julianjc84/VORON_2.4_TOP_MOUNT_XRAIL/images/current/bottom.jpg

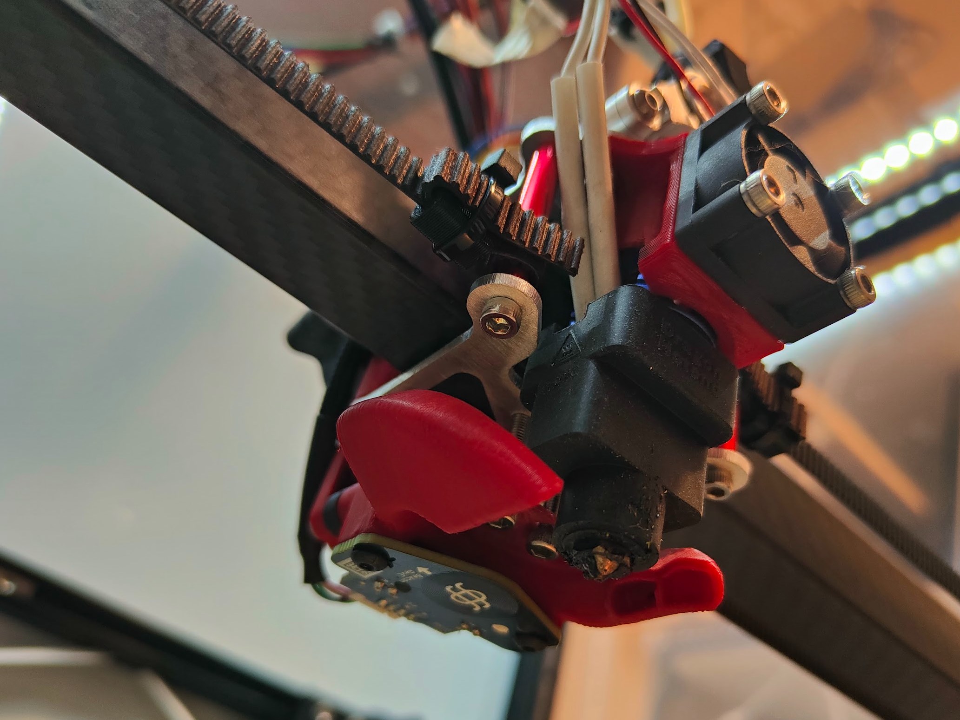
images/current/bottom.jpg
