julianjc84/VORON_2.4_TOP_MOUNT_XRAIL/images/v4/top_belt.png

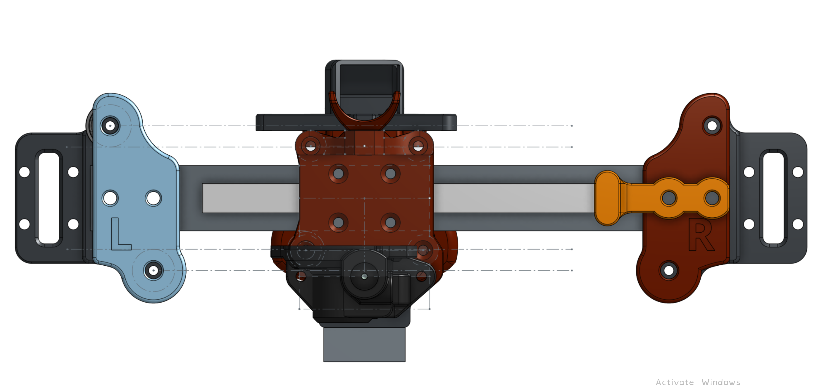
images/v4/top_belt.png
