julianjc84/VORON_2.4_TOP_MOUNT_XRAIL/images/vz/vzangled_belts.jpg

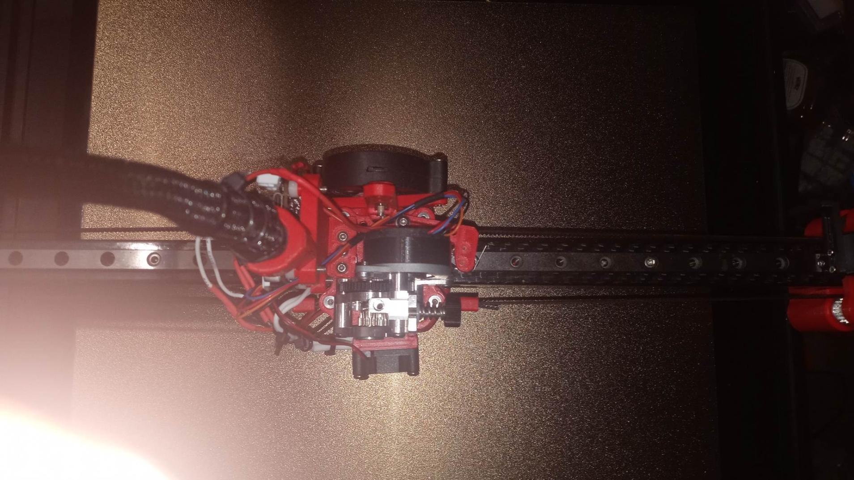
images/vz/vzangled_belts.jpg
