julianjc84/VORON_2.4_TOP_MOUNT_XRAIL/images/vz/vzstandard-vs-rr.png

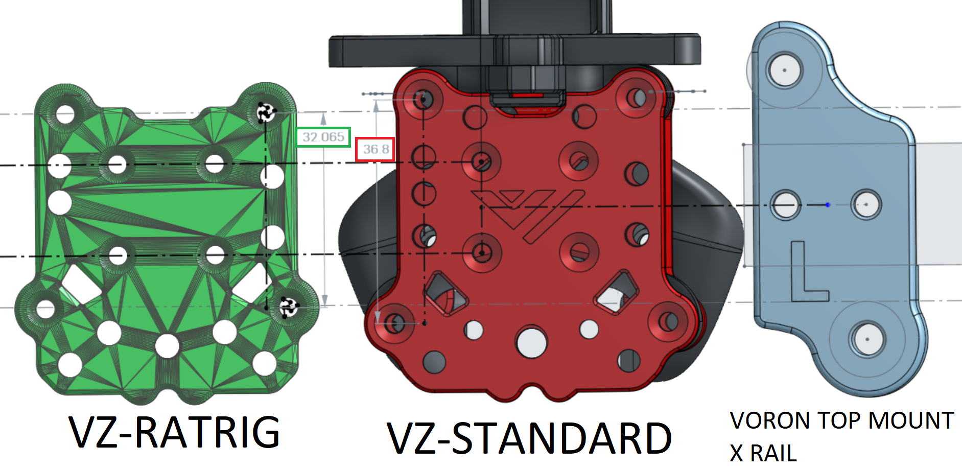
images/vz/vzstandard-vs-rr.png
