julianjc84/VORON_2.4_TOP_MOUNT_XRAIL/STL/LASERCUT_PART_LASER_dxF/XY/VZ_LAZER_3MM - XY_10MM_SPACER_BLOCK_FOR_ALUM_PLATE_FULLSIZE.stl

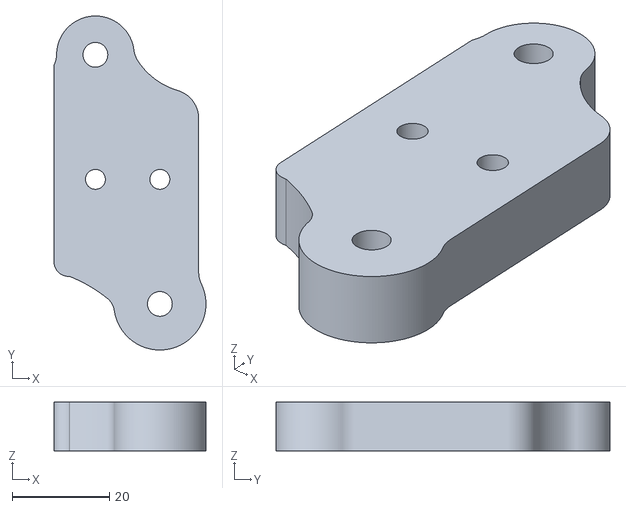
[picture p24: CAD file, 2023-10-03]
STL/LASERCUT_PART_LASER_dxF/XY/VZ_LAZER_3MM - XY_10MM_SPACER_BLOCK_FOR_ALUM_PLATE_FULLSIZE.stl
31.3 x 68.8 x 10.0
