julianjc84/VORON_2.4_TOP_MOUNT_XRAIL/STL/ADJUSTABLE_PROBE_MOUNT/Probe_Dock.stl

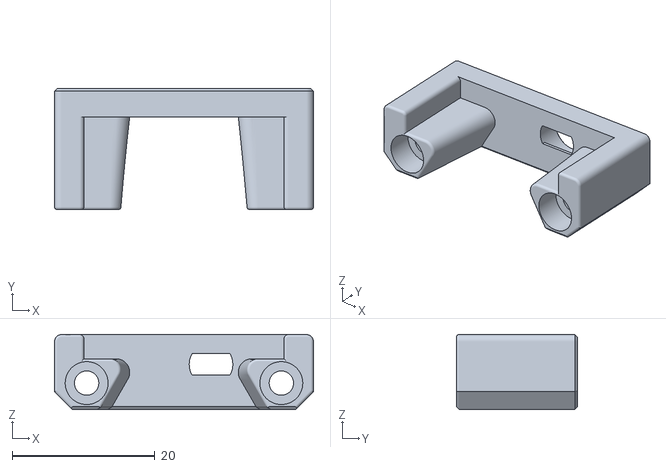
[picture p25: CAD file, 2023-04-02]
STL/ADJUSTABLE_PROBE_MOUNT/Probe_Dock.stl
36.3 x 17.0 x 10.5
