julianjc84/VORON_2.4_TOP_MOUNT_XRAIL/STL/LASERCUT_PART_LASER_dxF/tool head/VZ_LAZER_3MM - 3MM_VORON_VZ_TOP_PLATE_MGN9H.dxf

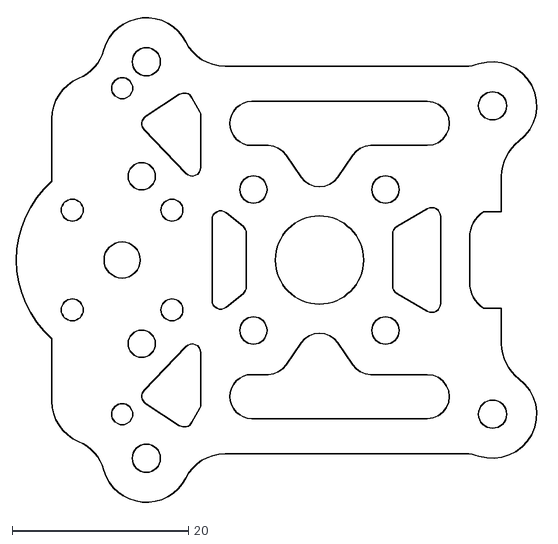
[picture p26: CAD file, 2023-10-03]
STL/LASERCUT_PART_LASER_dxF/tool head/VZ_LAZER_3MM - 3MM_VORON_VZ_TOP_PLATE_MGN9H.dxf
59.6 x 55.3
