julianjc84/VORON_2.4_TOP_MOUNT_XRAIL/STL/LASERCUT_PART_LASER_dxF/x beam/xbeam_flat_2mm holes.dxf

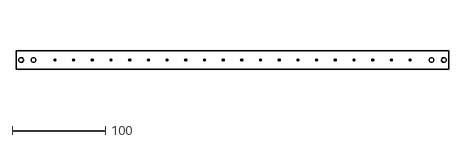
[picture p27: CAD file, 2023-10-03]
STL/LASERCUT_PART_LASER_dxF/x beam/xbeam_flat_2mm holes.dxf
463.0 x 20.0
