julianjc84/VORON_2.4_TOP_MOUNT_XRAIL/STL/V4_CARRIAGE/_V4_43_ - _CARRIAGE_TOP.stl

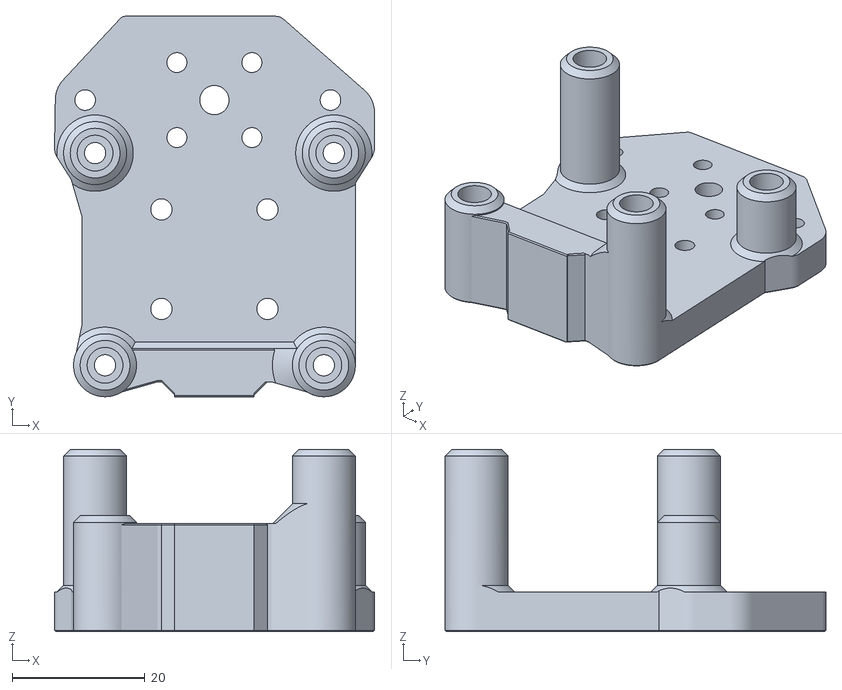
[picture p28: CAD file, 2023-04-02]
STL/V4_CARRIAGE/_V4_43_ - _CARRIAGE_TOP.stl
48.3 x 57.4 x 27.5
