julianjc84/VORON_2.4_TOP_MOUNT_XRAIL/STL/VZ REAR FAN DUCT 5015 BEACON CUTOUT CUSTOM/XTOP_B3-47_ - Rear sliding mount 5015.stl

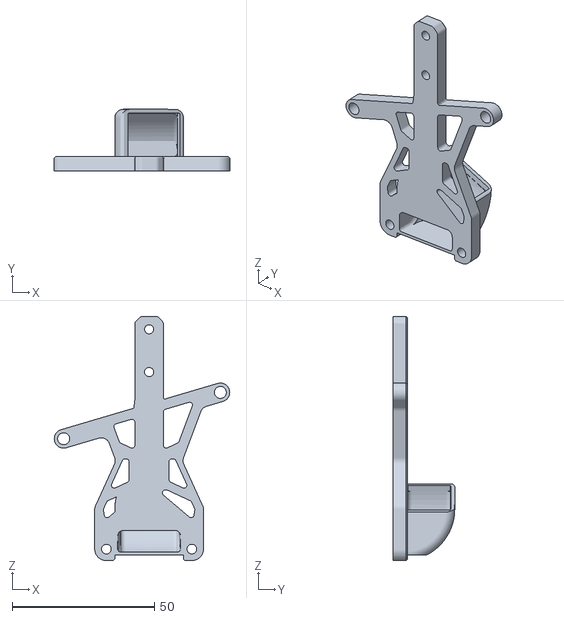
[picture p29: CAD file, 2023-05-09]
STL/VZ REAR FAN DUCT 5015 BEACON CUTOUT CUSTOM/XTOP_B3-47_ - Rear sliding mount 5015.stl
61.6 x 21.6 x 85.7
