julianjc84/VORON_2.4_TOP_MOUNT_XRAIL/STL/VZ TOP PLATE DRAGON UHF CUSTOM/XTOP_B3-47_ - vz_Top plate MGN9H.stl

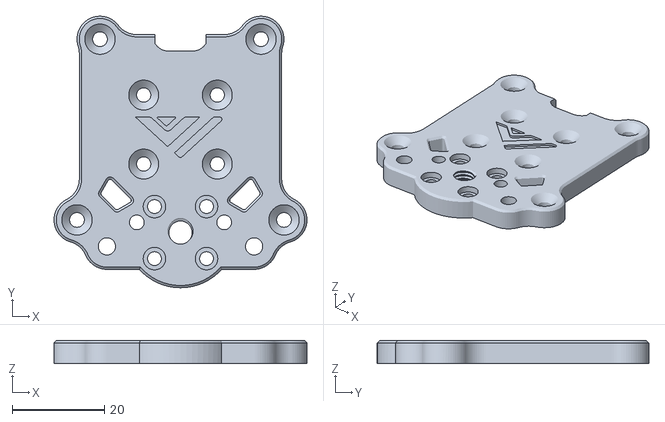
[picture p30: CAD file, 2023-05-09]
STL/VZ TOP PLATE DRAGON UHF CUSTOM/XTOP_B3-47_ - vz_Top plate MGN9H.stl
55.0 x 59.0 x 5.00
