julianjc84/VORON_2.4_TOP_MOUNT_XRAIL/STL/XY/XTOP_B3-47_ - _Z_BELT_CLIP_OFFSETSPACER.stl

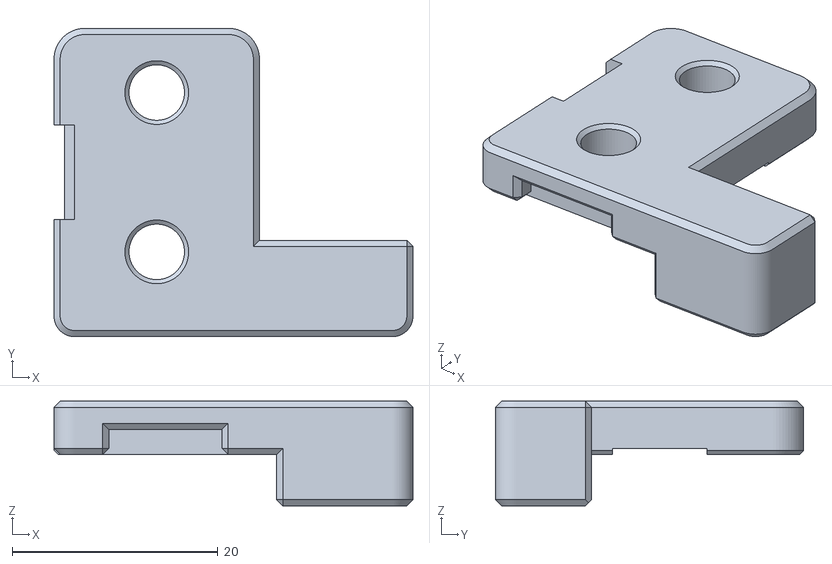
[picture p31: CAD file, 2023-05-09]
STL/XY/XTOP_B3-47_ - _Z_BELT_CLIP_OFFSETSPACER.stl
34.9 x 30.0 x 10.2
