julianjc84/VORON_2.4_TOP_MOUNT_XRAIL/STL/XY/XY_VZ_505SPACE_NEW_BUILD/HEATSET/PA_B3_V47_ - _MATCHVZSPACING_XY_RIGHT_BOTTOM.stl

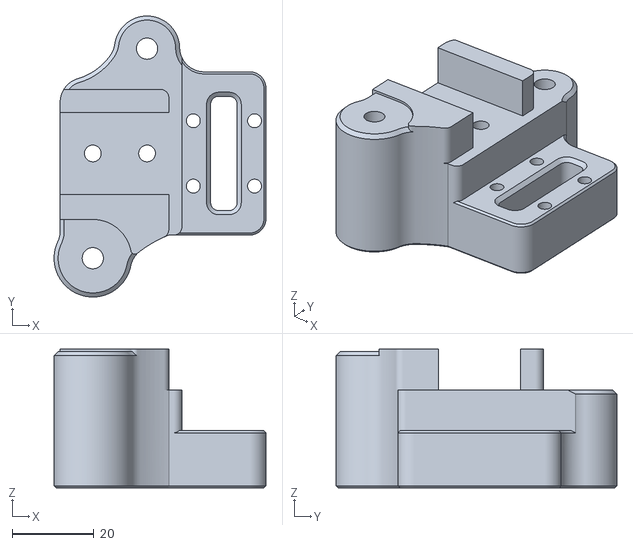
[picture p32: CAD file, 2023-04-25]
STL/XY/XY_VZ_505SPACE_NEW_BUILD/HEATSET/PA_B3_V47_ - _MATCHVZSPACING_XY_RIGHT_BOTTOM.stl
51.9 x 68.8 x 34.0
