julianjc84/VORON_2.4_TOP_MOUNT_XRAIL/STL/Z_CHAIN_BED_MOUNT/Z_CHAIN_BED_MOUNT_BRACKET.stl

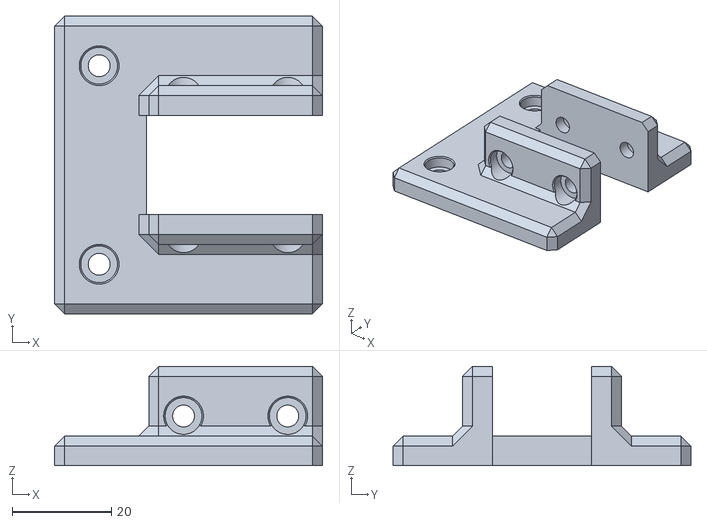
[picture p33: CAD file, 2023-04-02]
STL/Z_CHAIN_BED_MOUNT/Z_CHAIN_BED_MOUNT_BRACKET.stl
54.0 x 60.0 x 20.0
