julianjc84/VORON_2.4_TOP_MOUNT_XRAIL/STL/ADJUSTABLE_PROBE_MOUNT/DockMountAdjustable_BOTTOM.stl

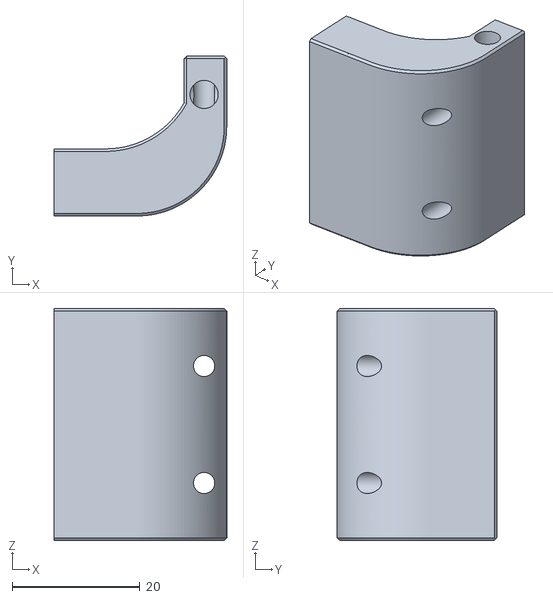
[picture p34: CAD file, 2023-04-02]
STL/ADJUSTABLE_PROBE_MOUNT/DockMountAdjustable_BOTTOM.stl
27.0 x 25.0 x 36.3
