julianjc84/VORON_2.4_TOP_MOUNT_XRAIL/STL/LASERCUT_PART_LASER_dxF/x beam/xbeam_flat_3mm holes.dxf

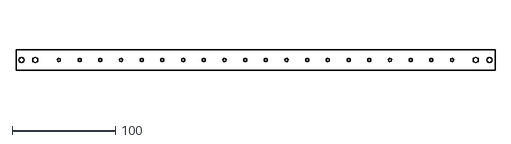
[picture p36: CAD file, 2023-10-03]
STL/LASERCUT_PART_LASER_dxF/x beam/xbeam_flat_3mm holes.dxf
463.0 x 20.0
