julianjc84/VORON_2.4_TOP_MOUNT_XRAIL/STL/V4_CARRIAGE/_V4_43_ - _VZ_Rear_5015_PROBE.stl

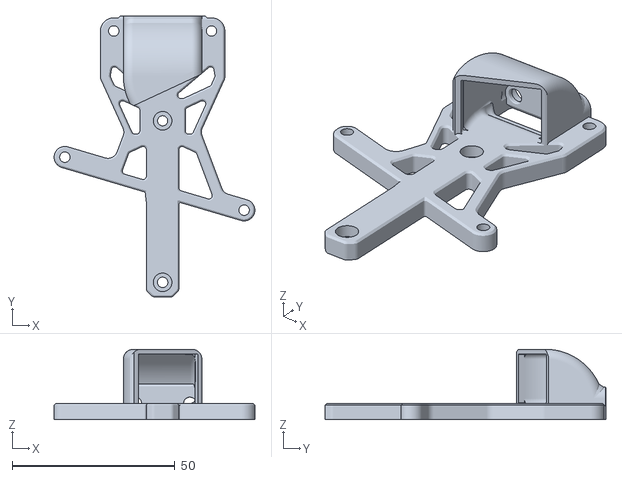
[picture p37: CAD file, 2023-04-02]
STL/V4_CARRIAGE/_V4_43_ - _VZ_Rear_5015_PROBE.stl
61.6 x 86.3 x 21.6
