julianjc84/VORON_2.4_TOP_MOUNT_XRAIL/STL/XY/_XY_RIGHT_BOTTOM.stl

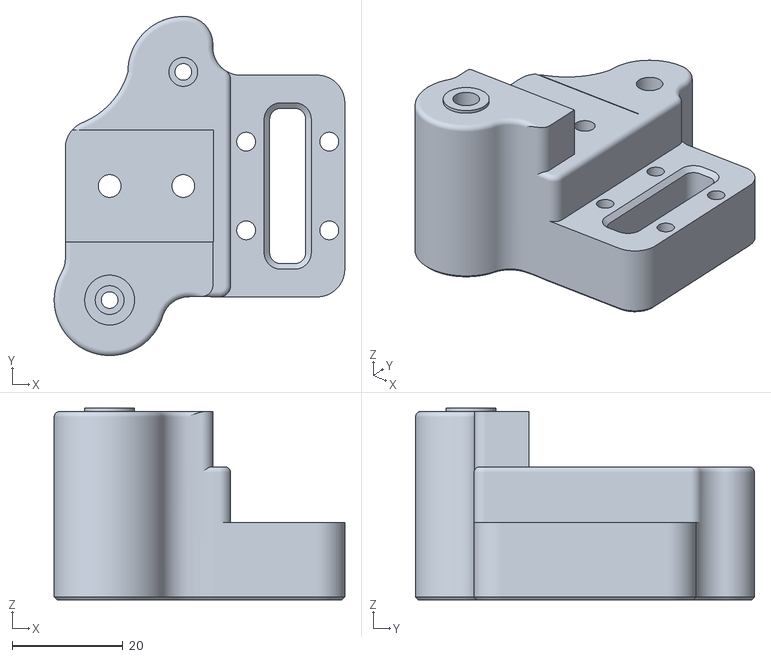
[picture p38: CAD file, 2023-04-02]
STL/XY/_XY_RIGHT_BOTTOM.stl
52.4 x 61.1 x 34.6
