julianjc84/VORON_2.4_TOP_MOUNT_XRAIL/STL/ADJUSTABLE_PROBE_MOUNT/DockMountAdjustable_TOP.stl

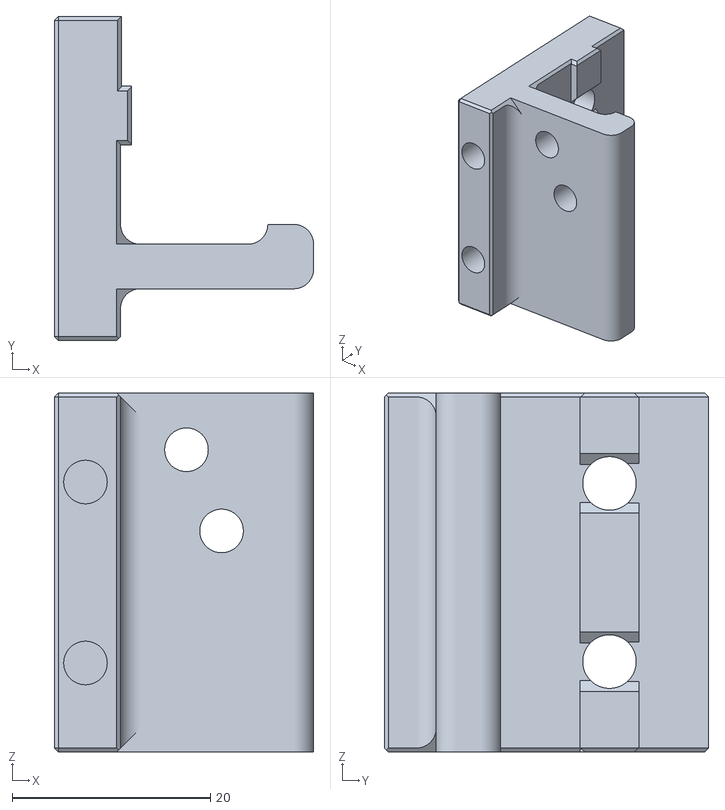
[picture p39: CAD file, 2023-04-02]
STL/ADJUSTABLE_PROBE_MOUNT/DockMountAdjustable_TOP.stl
26.2 x 32.7 x 36.3
