julianjc84/VORON_2.4_TOP_MOUNT_XRAIL/STL/V4_CARRIAGE/_V4_43_ - _25X25_FAN_MOUNT.stl

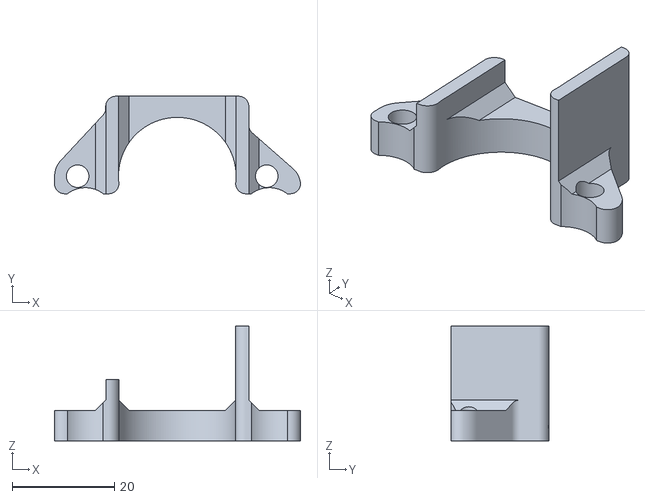
[picture p41: CAD file, 2023-04-02]
STL/V4_CARRIAGE/_V4_43_ - _25X25_FAN_MOUNT.stl
48.1 x 19.1 x 22.5
