julianjc84/VORON_2.4_TOP_MOUNT_XRAIL/STL/LASERCUT_PART_LASER_dxF/XY/VZ_LAZER_3MM - 3MM XY BOTTOM LH-RH x2.dxf

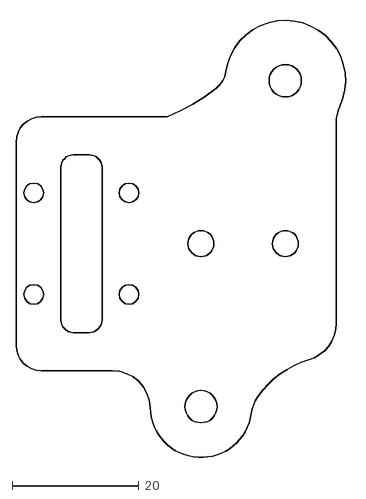
[picture p44: CAD file, 2023-10-03]
STL/LASERCUT_PART_LASER_dxF/XY/VZ_LAZER_3MM - 3MM XY BOTTOM LH-RH x2.dxf
52.6 x 69.7
