julianjc84/VORON_2.4_TOP_MOUNT_XRAIL/STL/V4_CARRIAGE/_V4_43_ - _Z_BELT_CLIP_8MM_OFFSETSPACER.stl

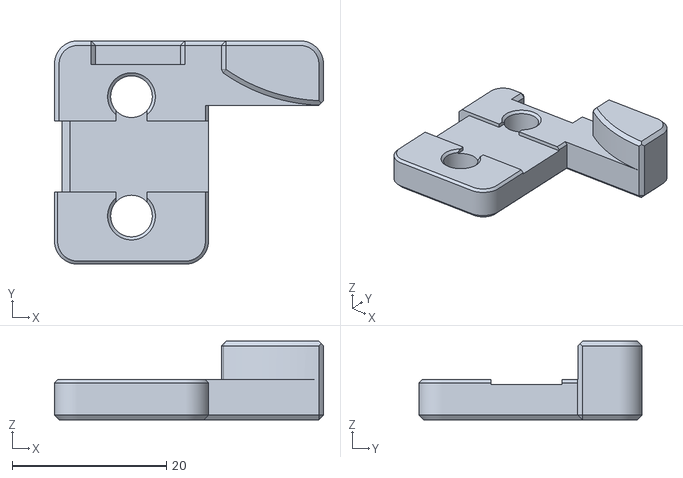
[picture p45: CAD file, 2023-04-02]
STL/V4_CARRIAGE/_V4_43_ - _Z_BELT_CLIP_8MM_OFFSETSPACER.stl
34.9 x 29.0 x 10.2
