julianjc84/VORON_2.4_TOP_MOUNT_XRAIL/STL/XY/_CARBON_INTERNAL.stl

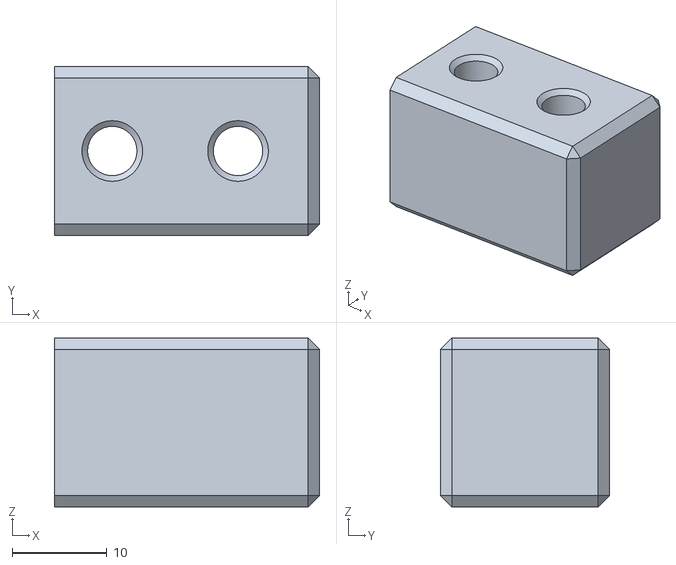
[picture p46: CAD file, 2023-04-02]
STL/XY/_CARBON_INTERNAL.stl
28.0 x 17.9 x 17.9
