julianjc84/VORON_2.4_TOP_MOUNT_XRAIL/STL/V4_CARRIAGE/_V4_43_ - _TRITHORN_SUPPORT_PIN_x2.stl

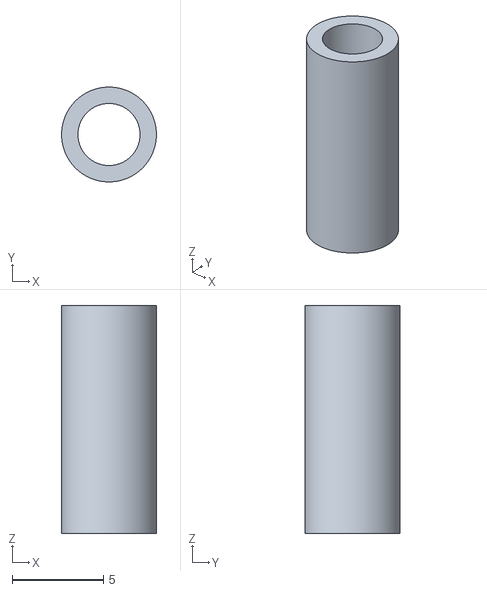
[picture p47: CAD file, 2023-04-02]
STL/V4_CARRIAGE/_V4_43_ - _TRITHORN_SUPPORT_PIN_x2.stl
5.20 x 5.20 x 12.5
