julianjc84/VORON_2.4_TOP_MOUNT_XRAIL/STL/V4_CARRIAGE/_V4_43_ - _VZ_CABLE_HOLDER.stl

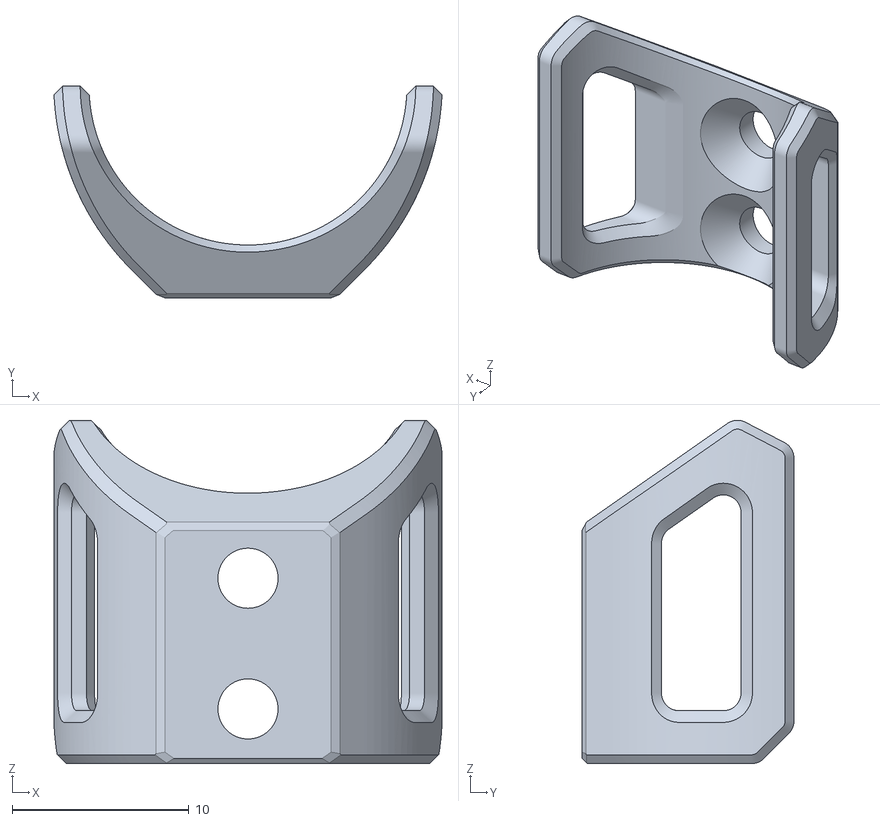
[picture p49: CAD file, 2023-04-02]
STL/V4_CARRIAGE/_V4_43_ - _VZ_CABLE_HOLDER.stl
22.0 x 12.0 x 19.4
