julianjc84/VORON_2.4_TOP_MOUNT_XRAIL/STL/XY/_XY_RIGHT_TOP.stl

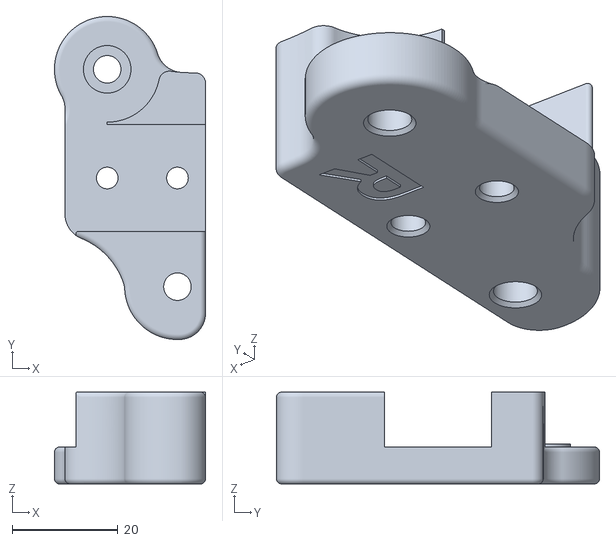
[picture p50: CAD file, 2023-04-02]
STL/XY/_XY_RIGHT_TOP.stl
28.6 x 61.1 x 17.4
