julianjc84/VORON_2.4_TOP_MOUNT_XRAIL/STL/V4_CARRIAGE/_V4_43_ - _CARRAGE_BOTTOM.stl

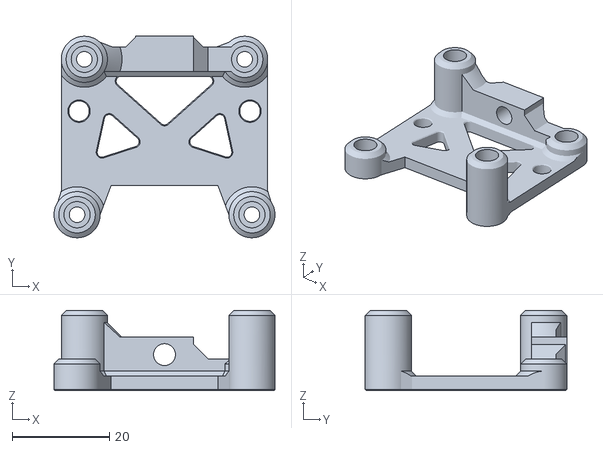
[picture p51: CAD file, 2023-04-02]
STL/V4_CARRIAGE/_V4_43_ - _CARRAGE_BOTTOM.stl
45.5 x 41.5 x 16.5
