julianjc84/VORON_2.4_TOP_MOUNT_XRAIL/STL/XY/_X_END_STOP_SENSORLESS_BLOCK.stl

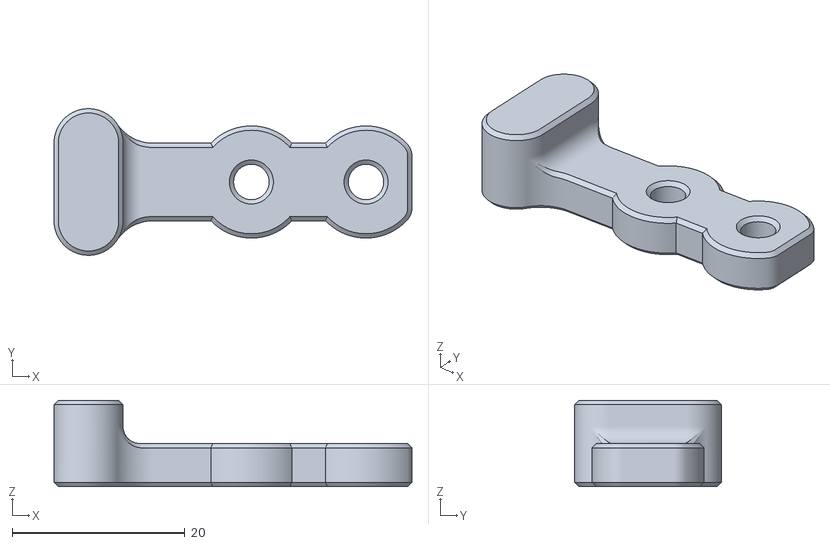
[picture p52: CAD file, 2023-04-02]
STL/XY/_X_END_STOP_SENSORLESS_BLOCK.stl
41.5 x 17.0 x 10.0
