julianjc84/VORON_2.4_TOP_MOUNT_XRAIL/STL/V4_CARRIAGE/_V4_43_ - _CARRIAGE_FAN_REAR.stl

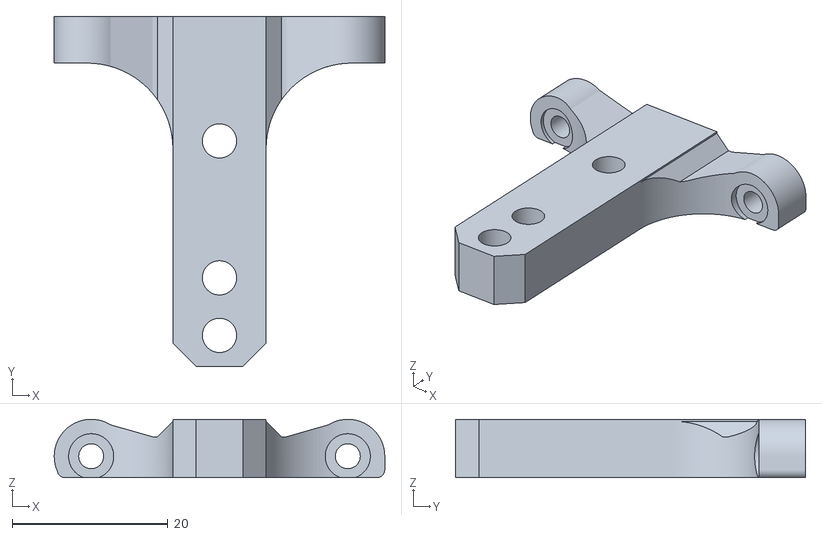
[picture p53: CAD file, 2023-04-02]
STL/V4_CARRIAGE/_V4_43_ - _CARRIAGE_FAN_REAR.stl
42.5 x 45.0 x 7.50
