julianjc84/VORON_2.4_TOP_MOUNT_XRAIL/(list of files, cad)

Other CAD files:
STL/XY/XY_VZ_505SPACE_NEW_BUILD/HEXNUTS/PA_B3_V47_ - _MATCHVZSPACING_XY_LEFT_BOTTOM.stl
STL/XY/XY_VZ_505SPACE_NEW_BUILD/HEATSET/PA_B3_V47_ - _MATCHVZSPACING_XY_LEFT_BOTTOM.stl
STL/XY/XY_VZ_505SPACE_NEW_BUILD/HEXNUTS/PA_B3_V47_ - _MATCHVZSPACING_XY_RIGHT_BOTTOM.stl
STL/XY/XY_VZ_505SPACE_NEW_BUILD/HEXNUTS/PA_B3_V47_ - _MATCHVZSPACING_XY_LEFT_TOP.stl
STL/XY/XY_VZ_505SPACE_NEW_BUILD/HEATSET/PA_B3_V47_ - _MATCHVZSPACING_XY_LEFT_TOP.stl
