julianjc84/VORON_2.4_TOP_MOUNT_XRAIL/images/issues/collide2.jpg

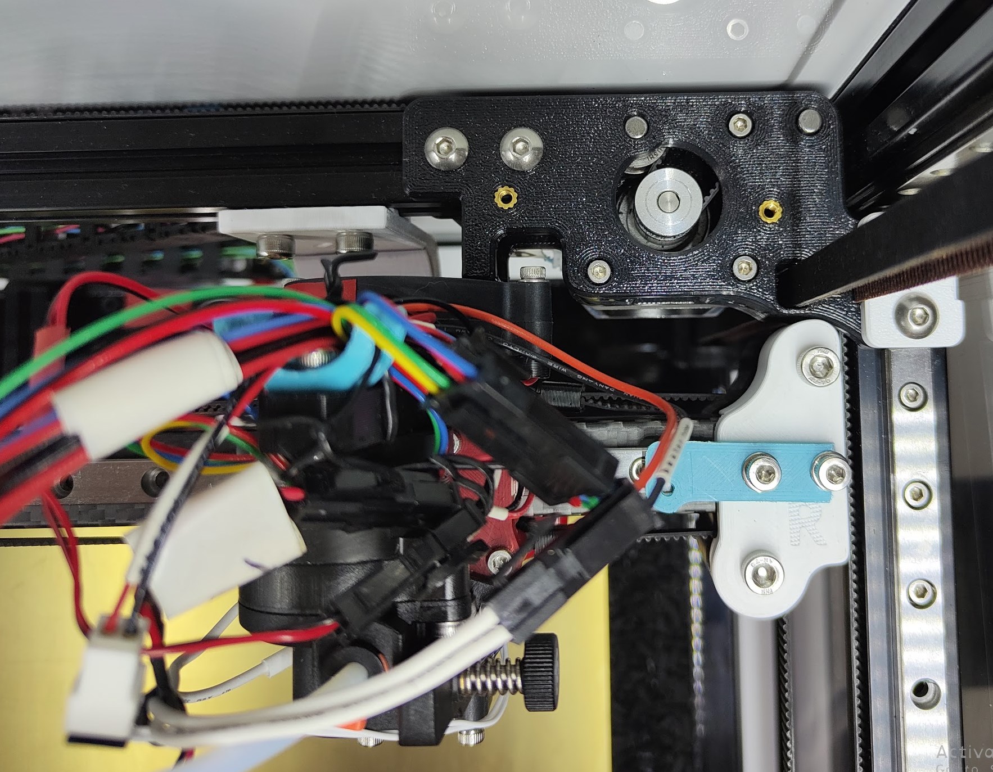
images/issues/collide2.jpg
