julianjc84/VORON_2.4_TOP_MOUNT_XRAIL/(commit log)

2023-04-21 belt issues updates
2023-04-21 updated idlers
    [_V4_44_VZ505SPACE_XY_LEFT_BOTTOM.stl, _V4_44_VZ505SPACE_XY_LEFT_TOP.stl, _V4_44_VZ505SPACE_XY_RIGHT_BOTTOM.stl, _V4_44_VZ505SPACE_XY_RIGHT_TOP.stl]
2023-04-21 folder organization of printed parts
    [DockMountAdjustable_BOTTOM.stl, DockMountAdjustable_TOP.stl, Probe_Dock.stl, _V4_43_ - _25X25_FAN_MOUNT.stl, _V4_43_ - _CARRAGE_BOTTOM.stl, _V4_43_ - _CARRIAGE_FAN_REAR.stl, _V4_43_ - _CARRIAGE_TOP.stl, _V4_43_ - _TRITHORN_SUPPORT_PIN_x2.stl]
2023-04-24 UPDATES
    VZSPACERS
    41 MMHOLES
    IDLER SPACING WITH M5 WASHERS GT20 FRONT
    ACCURATE BELT HEGIHTS
    [PA_B3_V45_V4_44_VZ505SPACE_XY_LEFT_BOTTOM.stl, PA_B3_V45_V4_44_VZ505SPACE_XY_LEFT_TOP.stl, PA_B3_V45_V4_44_VZ505SPACE_XY_RIGHT_BOTTOM.stl, PA_B3_V45_V4_44_VZ505SPACE_XY_RIGHT_TOP.stl, _V4_44_VZ505SPACE_XY_LEFT_BOTTOM.stl, _V4_44_VZ505SPACE_XY_LEFT_TOP.stl, _V4_44_VZ505SPACE_XY_RIGHT_BOTTOM.stl, _V4_44_VZ505SPACE_XY_RIGHT_TOP.stl]
2023-04-24 MATCHVZSPACING UPDATES
    [PA_B3_V45_ - _XY_LEFT_BOTTOM.stl, PA_B3_V45_ - _XY_LEFT_TOP.stl, PA_B3_V45_ - _XY_RIGHT_BOTTOM.stl, PA_B3_V45_ - _XY_RIGHT_TOP.stl, PA_B3_V45_V4_44_VZ505SPACE_XY_LEFT_BOTTOM.stl, PA_B3_V45_V4_44_VZ505SPACE_XY_LEFT_TOP.stl, PA_B3_V45_V4_44_VZ505SPACE_XY_RIGHT_BOTTOM.stl, PA_B3_V45_V4_44_VZ505SPACE_XY_RIGHT_TOP.stl]
2023-04-24 heatsets on xy
    [PA_B3_V46_ - _MATCHVZSPACING_XY_LEFT_BOTTOM.stl, PA_B3_V46_ - _MATCHVZSPACING_XY_RIGHT_BOTTOM.stl]
2023-04-25 BETTER ALIGNMENS
    [PA_B3_V46_ - _MATCHVZSPACING_XY_LEFT_BOTTOM.stl, PA_B3_V46_ - _MATCHVZSPACING_XY_LEFT_TOP.stl, PA_B3_V46_ - _MATCHVZSPACING_XY_RIGHT_BOTTOM.stl, PA_B3_V46_ - _MATCHVZSPACING_XY_RIGHT_TOP.stl, PA_B3_V47_ - _MATCHVZSPACING_XY_LEFT_BOTTOM.stl, PA_B3_V47_ - _MATCHVZSPACING_XY_LEFT_TOP.stl, PA_B3_V47_ - _MATCHVZSPACING_XY_RIGHT_BOTTOM.stl, PA_B3_V47_ - _MATCHVZSPACING_XY_RIGHT_TOP.stl]
2023-04-25 ENABLED HEX NUTN
    [PA_B3_V47_ - _MATCHVZSPACING_XY_LEFT_BOTTOM.stl, PA_B3_V47_ - _MATCHVZSPACING_XY_LEFT_TOP.stl, PA_B3_V47_ - _MATCHVZSPACING_XY_RIGHT_BOTTOM.stl, PA_B3_V47_ - _MATCHVZSPACING_XY_RIGHT_TOP.stl]
2023-10-03 updates laser
    [VZ_LAZER_3MM - 3MM XY BOTTOM LH-RH x2.dxf, VZ_LAZER_3MM - 3MM XY TOP LH-RH x2.dxf, VZ_LAZER_3MM - 3MM_VORON_VZ BOTTOM_PLATE.dxf, VZ_LAZER_3MM - 3MM_VORON_VZ_TOP_PLATE_MGN9H.dxf, VZ_LAZER_3MM - XY_10MM_SPACER_BLOCK_FOR_ALUM_PLATE_FULLSIZE.stl, VZ_LAZER_3MM - XY_10MM_SPACER_BLOCK_FOR_ALUM_PLATE_FULLSIZE_front_left_1mm.stl, xrail&carbon - CARBON AND MGN9H 463mm.dxf]
